stro/brass-trimmer/(commit log)

2021-08-20 Initial commit: TrimmerAdapter
    [TrimmerAdapter.scad, threads-library-by-cuiso-v1.scad]
2021-08-20 Updated documentation with correct bolts. Adjusted the thread tolerance
    [TrimmerAdapter.scad]
2021-08-20 Clarified the length with 'short_threads'
    [TrimmerAdapter.scad]
2021-08-21 Made adapter a little shorter; added explanation for a need of shorter bars
    [TrimmerAdapter.scad]
2021-08-24 Corrected the inside part of Drill Master adapter
    [TrimmerAdapter.scad]
2021-08-25 Added the 'extra_short' option
    [TrimmerAdapter.scad]
2021-08-25 Removed the center_hole slope to make less calculations for short adapters
    [TrimmerAdapter.scad]
2021-09-03 Simplified setup by removing extra_small; made the body the same diameter as a vac manifold
    [TrimmerAdapter.scad]
2021-09-11 Few tweaks and narrower body over threads for better internal walls
    [TrimmerAdapter.scad]
